jsnoeijs/PCBdesigns/GPSclock/pcb/3D_PCB1_2023-05-05.png

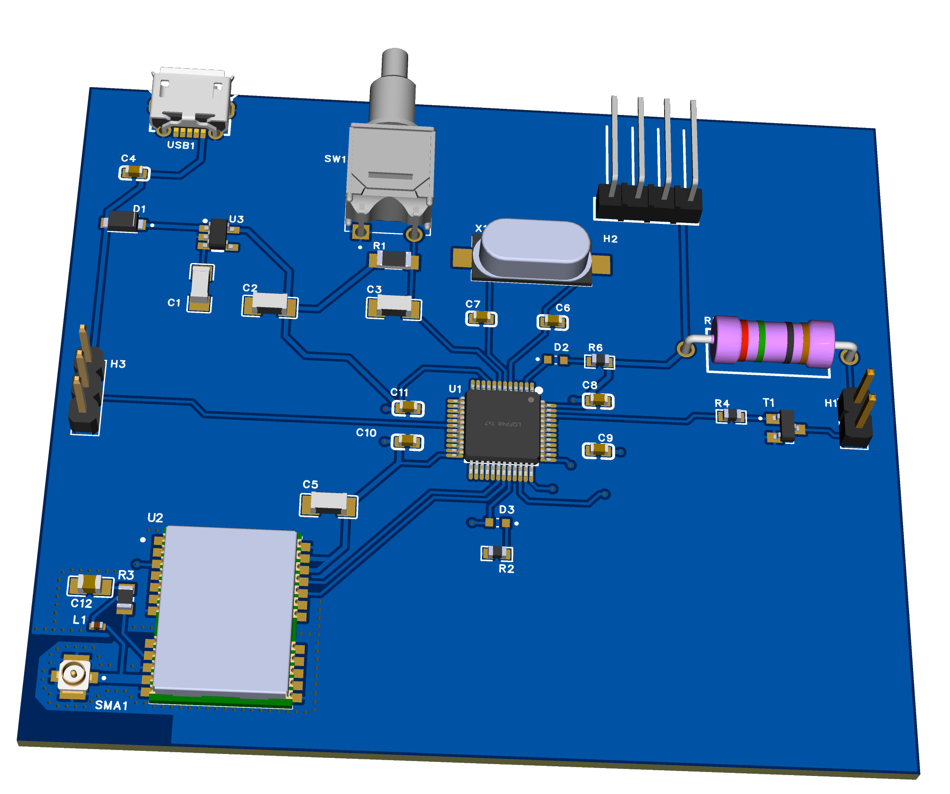
GPSclock/pcb/3D_PCB1_2023-05-05.png
