jsnoeijs/PCBdesigns/GPSclock/pcb/BOM_Board1_PCB1_2023-05-05.csv

No. | Quantity | Designator | Footprint | Value | Manufacturer Part | Manufacturer
1 | 2 | C1,C2 | C1206 | 10uF | CL31A106KBHNNNE | SAMSUNG(三星)
2 | 2 | C3,C5 | C1206 | 1uF | CL31B105KBHNNNE | SAMSUNG(三星)
3 | 1 | C4 | C0603 | 4.7uF | CL10A475KO8NNNC | SAMSUNG(三星)
4 | 2 | C6,C7 | C0603 | 20pF | CL10C200JB8NNNC | SAMSUNG(三星)
5 | 4 | C8,C9,C10,C11 | C0603 | 100nF | CC0603KRX7R9BB104 | YAGEO(国巨)
6 | 1 | C12 | C0805 | 10nF | CL21B103KBANNNC | SAMSUNG(三星)
7 | 1 | D1 | SODFL3718X102N |  | SS34LWH | Taiwan Semiconductor Corporation
8 | 1 | D2 | LED_APHD1608LVBC/D | RED | APTD1608LSURCK | Kingbright
9 | 1 | D3 | LED_APHD1608LVBC/D | YELLOW | APTD1608LSYCK | Kingbright
10 | 1 | H1 | WURTH_61300211121 |  | 61300211121 | Würth Elektronik
11 | 1 | H2 | HDR-TH_4P-P2.54-H-M-W9.5 |  | 22052041 | MOLEX
12 | 1 | H3 | AMPHENOL_G800W305018EU |  | G800W305018EU | AMPHENOL
13 | 1 | L1 | BEADC1005X55N | 1KΩ@100MHz | BLM15HG102BH1D | Murata Electronics
14 | 1 | R1 | RES_ERA8AEB103V | 10KΩ
15 | 1 | R2 | R0603_NEW | 470Ω | RC0603FR-13470RL | YAGEO
16 | 1 | R3 | RESC2012X60N | 10Ω | SR0805FR-4710RL | YAGEO
17 | 1 | R4 | R0603_NEW | 1KΩ | RC0603FR-101KL | YAGEO
18 | 1 | R5 | RES-TH_BD4.5-L11.5-P15.50-D0.8 | 3.9Ω | RSF100JR-73-3R9 | YAGEO(国巨)
19 | 1 | R6 | R0603_NEW | 680Ω | RC0603FR-13680RL | YAGEO
20 | 1 | SMA1 | MOLEX_0734120110 |  | 0734120110 | MOLEX
21 | 1 | SW1 | SW_800SP9B6M6RE |  | 800SP9B6M6RE | E-Switch
22 | 1 | T1 | TRANS_MMBT4401 |  | 4530-MMBT4401CT-ND | ANBON SEMICONDUCTOR LIMITED
23 | 1 | U1 | LQFP-48_L7.0-W7.0-P0.50-LS9.0-BL |  | STM32F103C8T6 | ST(意法半导体)
24 | 1 | U2 | XCVR_NEO-M8N-0 |  | NEO-M8N-0 | U-BLOX
25 | 1 | U3 | SOT-25-5_L2.9-W1.6-P0.95-LS2.8-BL |  | AP2112K-3.3TRG1 | DIODES(美台)
26 | 1 | USB1 | MICRO-USB-SMD_105017-0001 |  | 1050170001 | MOLEX
27 | 1 | X1 | XTAL_ECS-80-18-5PX-TR | 8MHz | ECS-80-18-5PX-TR | ECS inc
