jsnoeijs/PCBdesigns/GPSclock/pcb/SCH_gpsclock_2023-05-05.pdf

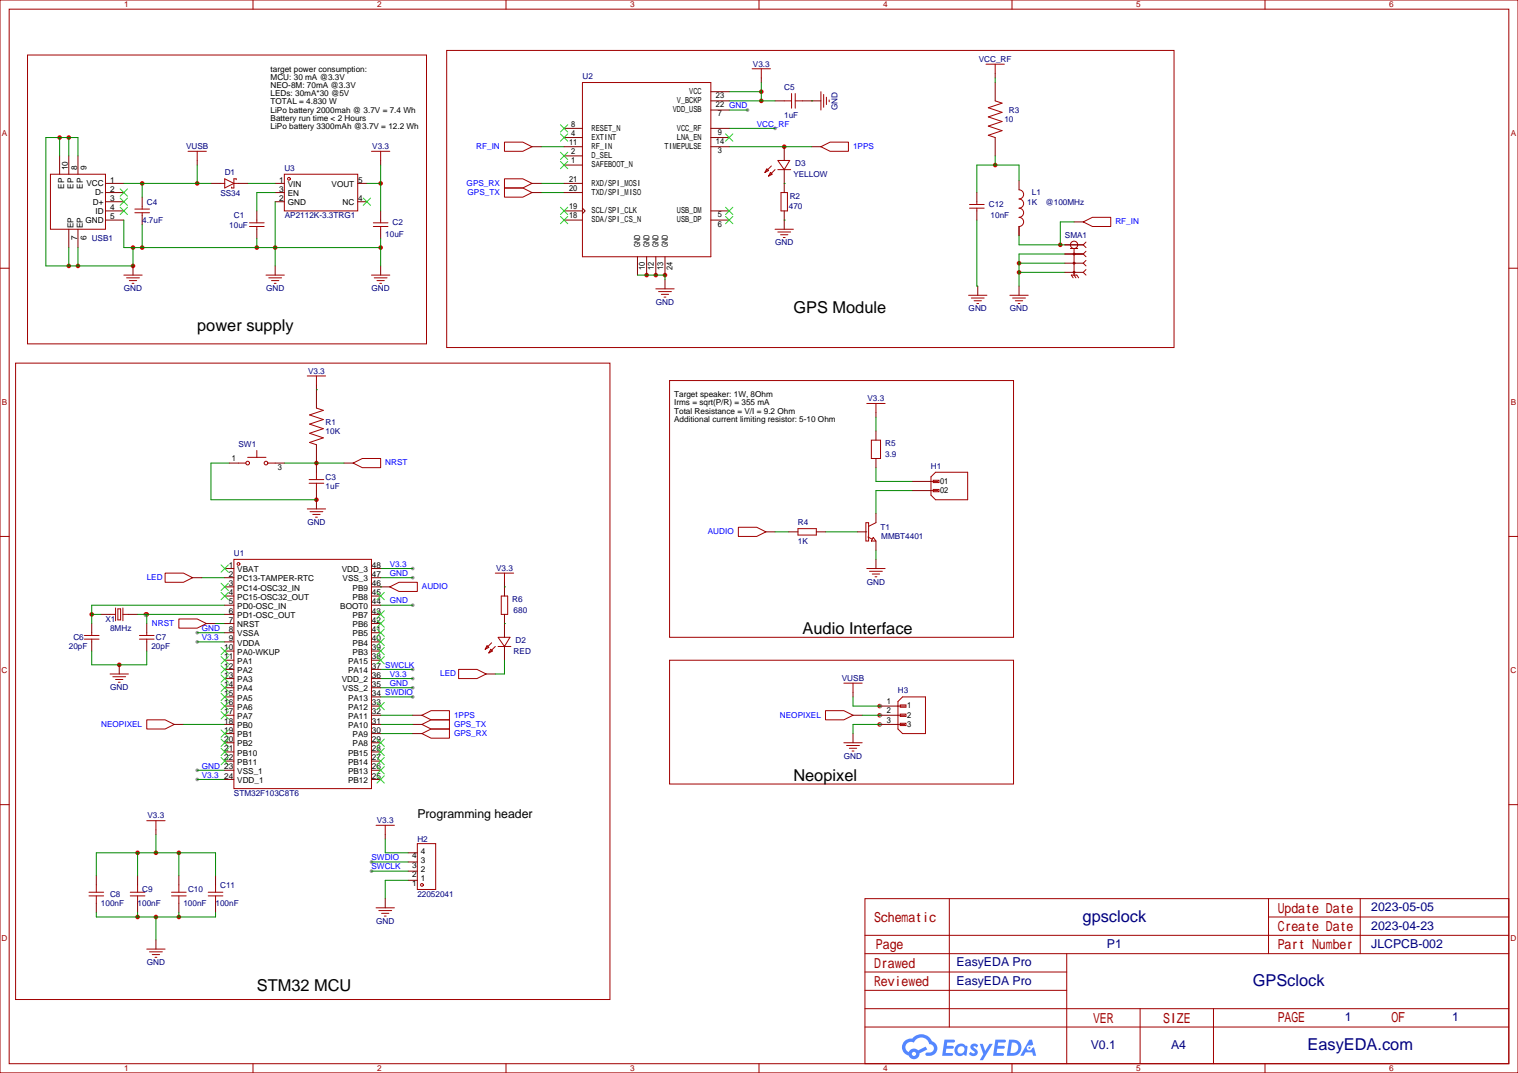
[picture p2: page 1]

target power consumption:
MCU: 30 mA @3.3V
NEO-8M: 70mA @3.3V
LEDs: 30mA*30 @5V
TOTAL = 4.830 W
LiPo battery 2000mah @ 3.7V = 7.4 Wh
Battery run time < 2 Hours
LiPo battery 3300mAh @3.7V = 12.2 Wh

Target speaker: 1W, 8Ohm
Irms = sqrt(P/R) = 355 mA
Total Resistance = V/I = 9.2 Ohm
Additional current limiting resistor: 5-10 Ohm
