jsnoeijs/PCBdesigns/GPSclock/pcb/PCB_PCB1_2023-05-05.pdf

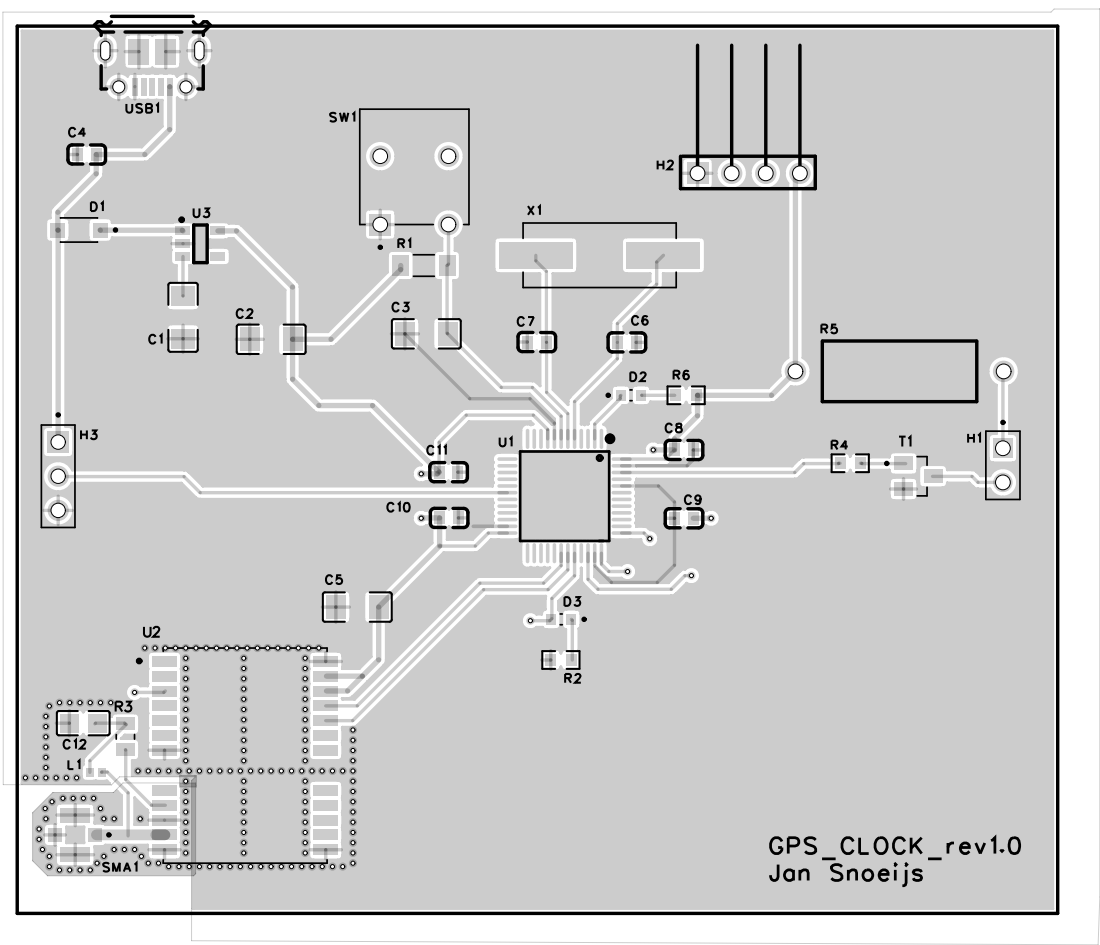
[picture p3: page 1]

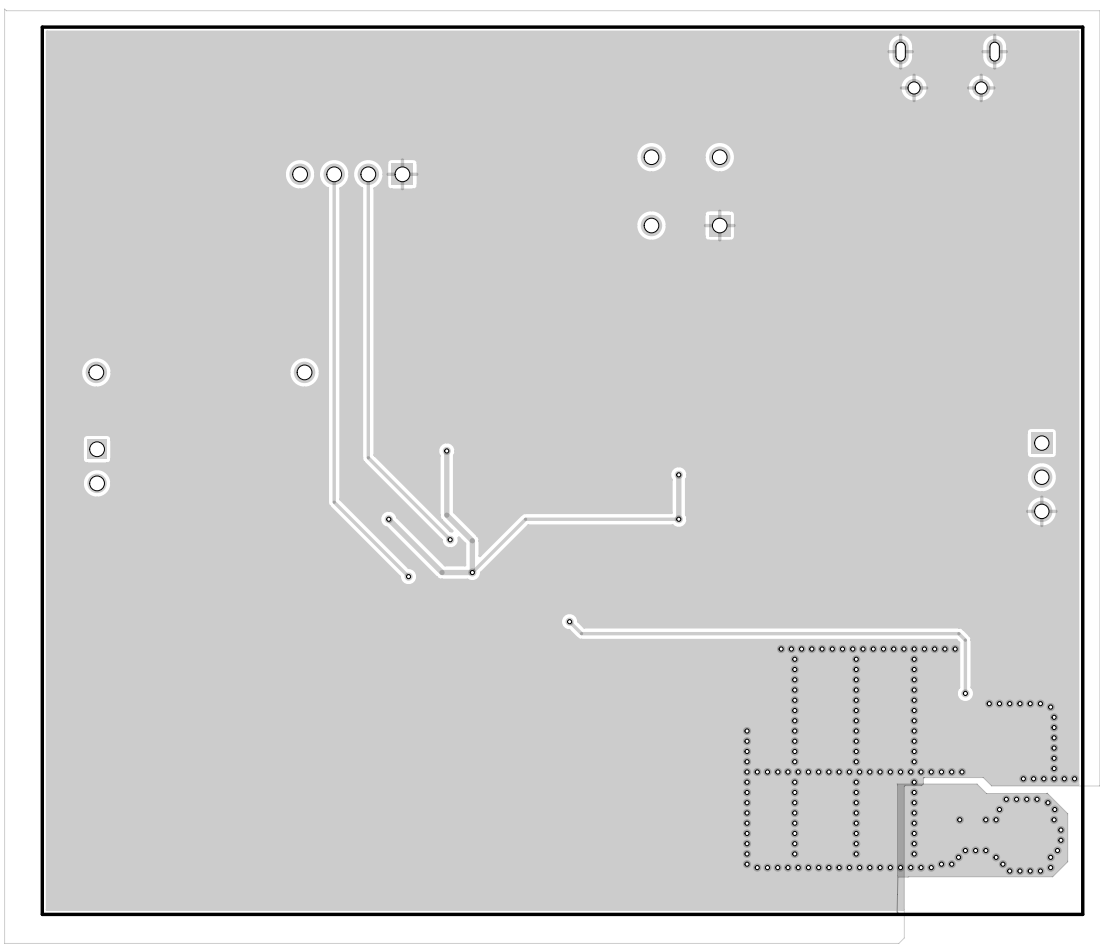
[picture p4: page 2]

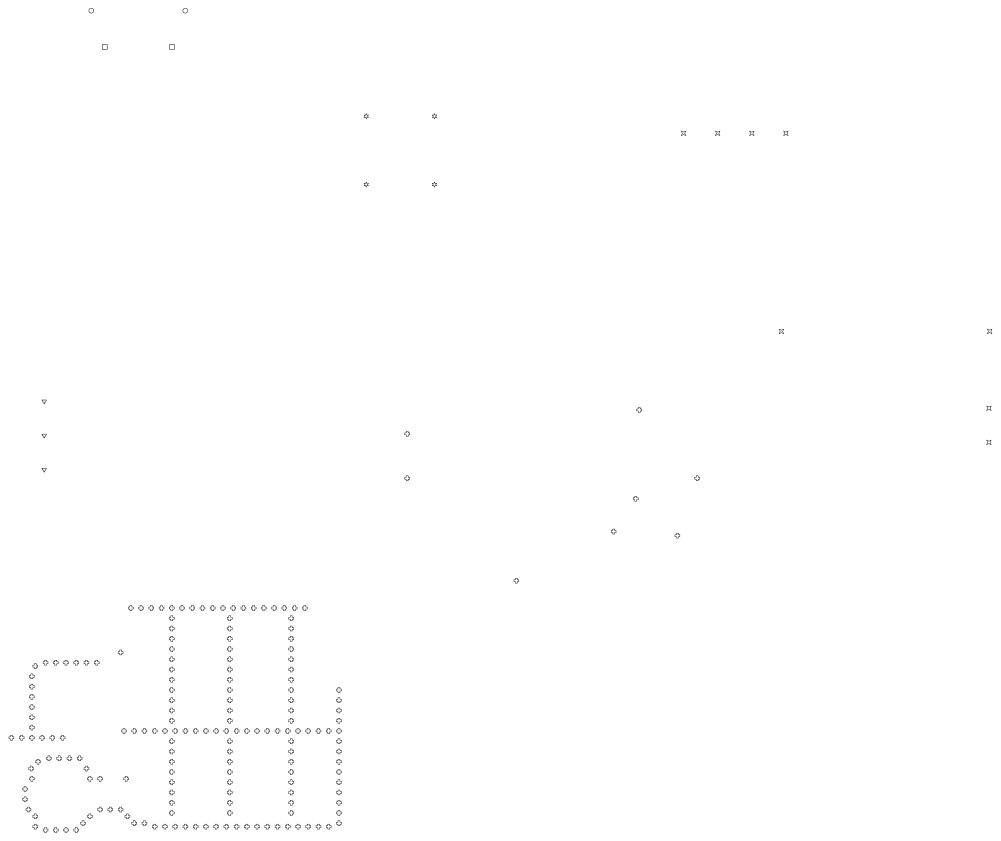
[picture p5: page 3]
