jsnoeijs/PCBdesigns/(list of files, drawings)

Other design files:
GPSclock/pcb/GPSclock.eprj
